przemykomo/nixie-watch/README.md

# Nixie Watch

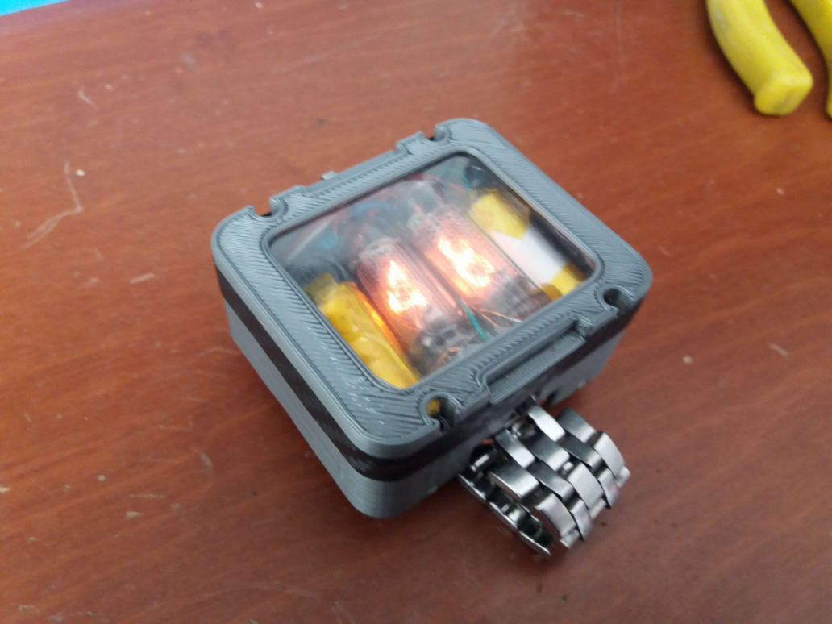
[picture p1: img/showcase.png]
Nixie Watch
