przemykomo/nixie-watch/models/watch_model.FCStd

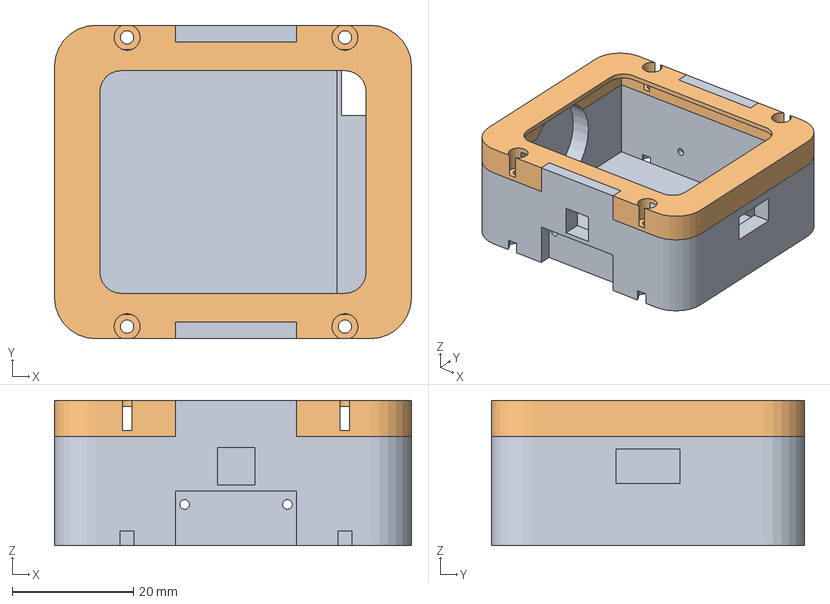
[picture p2: CAD file, 2023-12-17]
models/watch_model.FCStd
59.0 x 51.8 x 24.0 mm
Bottom (Meshed)
Top (Meshed)
