przemykomo/nixie-watch/schematics/nixiewatch.kicad_pcb

## KiCad design schematics/nixiewatch.kicad_pcb (2023-06-13)

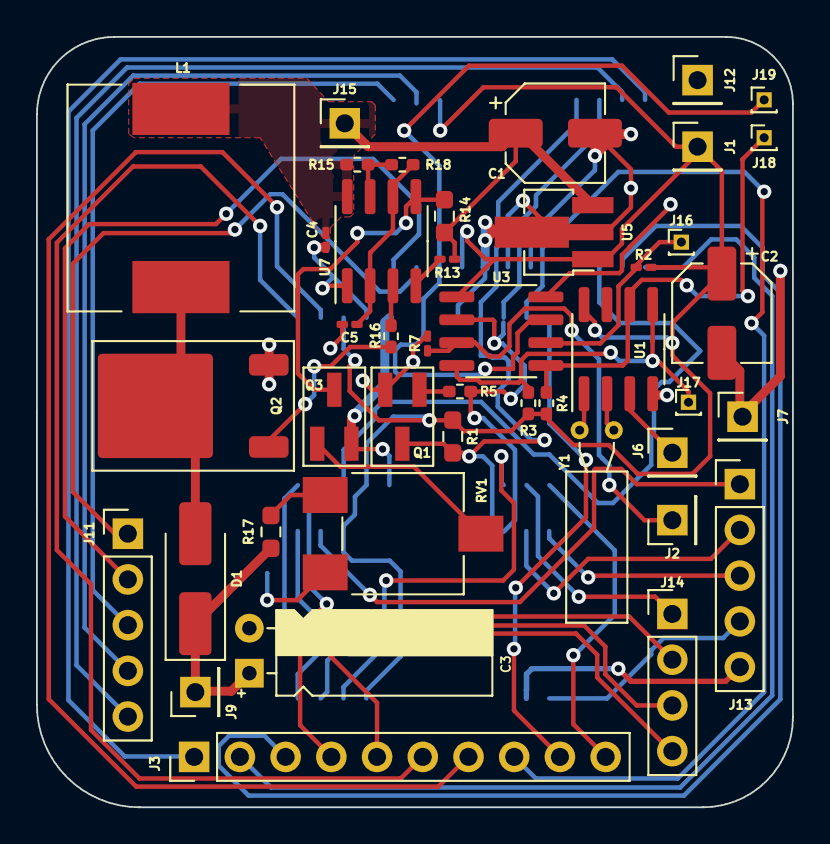
[picture p3: board nixiewatch.kicad_pcb from above]

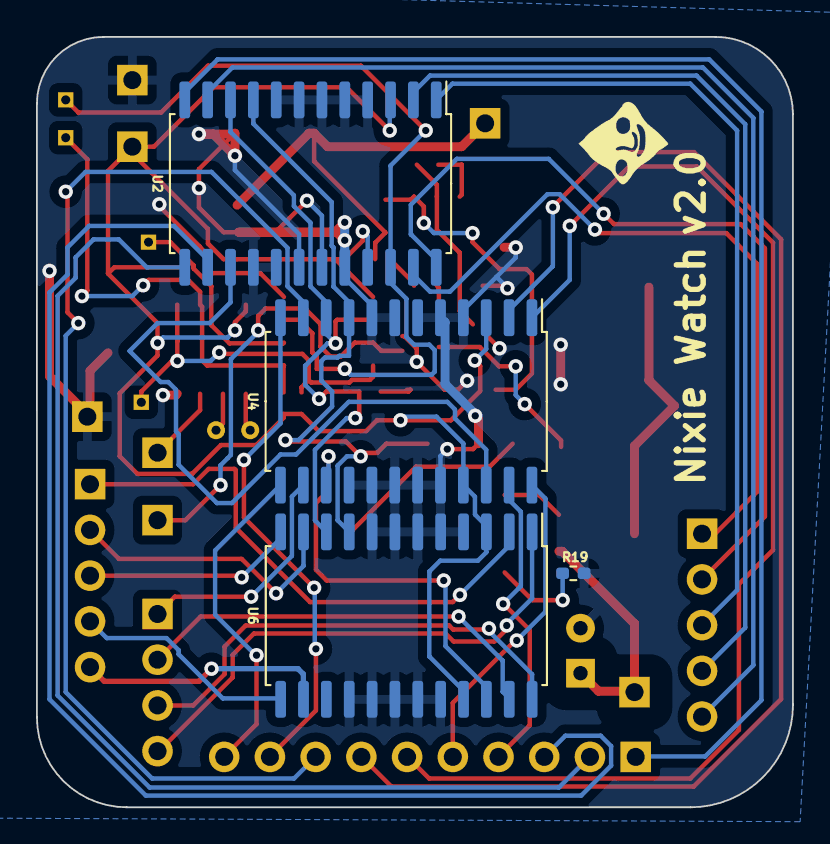
[picture p4: board nixiewatch.kicad_pcb from below]

Board: 2 copper layers, 42.0 x 42.8 mm, 47 parts (4 on the bottom side), 51 nets.

Parts:
C1, C2: 33u; CP_Elec_5x5.3
C3: 1u 200V; CP_RADIAL_D5.00mm_P2.50mm_H12.0mm_Horizontal
C4: 100n; C_0201_0603Metric_Pad0.64x0.40mm_HandSolder
C5: 2n2; C_0201_0603Metric_Pad0.64x0.40mm_HandSolder
D1: S1K; D_SMA_Handsoldering
J1, J9: ButtonH; PinHeader_1x01_P2.54mm_Vertical
J2: ButtonL; PinHeader_1x01_P2.54mm_Vertical
J3: Conn_01x10; PinHeader_1x10_P2.54mm_Vertical
J6: BT2_3V; PinHeader_1x01_P2.54mm_Vertical
J7: BT2GND; PinHeader_1x01_P2.54mm_Vertical
J11, J13: Conn_01x05; PinHeader_1x05_P2.54mm_Vertical
J12: BTGND; PinHeader_1x01_P2.54mm_Vertical
J14: Conn_01x04; PinHeader_1x04_P2.54mm_Vertical
J15: BT1_8V; PinHeader_1x01_P2.54mm_Vertical
J16: reset; PinHeader_1x01_P1.00mm_Vertical
J17: mosi; PinHeader_1x01_P1.00mm_Vertical
J18: miso; PinHeader_1x01_P1.00mm_Vertical
J19: sck; PinHeader_1x01_P1.00mm_Vertical
L1: 180u; L_12x12mm_H8mm
Q1, Q3: BC846A; SOT-23_Handsoldering
Q2: WMO10N60C2; TO-252-2
R1, R14: 51k; R_0603_1608Metric_Pad0.98x0.95mm_HandSolder
R2, R7, R13: 20k; R_0201_0603Metric_Pad0.64x0.40mm_HandSolder
R3, R4: 2k2; R_0402_1005Metric_Pad0.72x0.64mm_HandSolder
R5: 6k8; R_0402_1005Metric_Pad0.72x0.64mm_HandSolder
R15: 1k; R_0402_1005Metric_Pad0.72x0.64mm_HandSolder
R16: 100; R_0402_1005Metric_Pad0.72x0.64mm_HandSolder
R17: 680k; R_0603_1608Metric_Pad0.98x0.95mm_HandSolder
R18: 10k; R_0402_1005Metric_Pad0.72x0.64mm_HandSolder
R19: 470; R_0402_1005Metric_Pad0.72x0.64mm_HandSolder
RV1: 5k; Potentiometer_ACP_CA6-VSMD_Vertical
U1: DS1307Z+; SOIC-8_3.9x4.9mm_P1.27mm
U2, U4, U6: TPIC6A595DWR; SOIC-24W_7.5x15.4mm_P1.27mm
U3: ATtiny412-SS; SOIC-8_3.9x4.9mm_P1.27mm
U5: DI78M05UAB; SOT-89-3_Handsoldering
U7: NE555D; SOIC-8_3.9x4.9mm_P1.27mm
Y1: 32.768kHz 12.5pF; Crystal_C38-LF_D3.0mm_L8.0mm_Horizontal

Connections:
+3V0: J6.1, U1.3 (VBAT)
+5V: C2.1, J1.1, R1.2, R2.2, R3.1, R4.1, U1.8 (VCC), U2.3 (~SRCLR), U2.21 (VCC), U3.1 (VCC), U4.3 (~SRCLR), U4.21 (VCC), U5.1 (VO), U6.3 (~SRCLR), U6.21 (VCC)
+170V: C3.1, D1.1 (K), J9.1, R17.1
+BATT: C1.1, C4.1, J15.1, L1.1, R13.1, R14.1, R15.1, U5.3 (VI), U7.8 (VCC)
/170V_int: D1.2 (A), L1.2, Q2.2 (D)
/RCK: Q1.3 (C), R1.1, U2.9 (RCK), U4.9 (RCK), U6.9 (RCK)
/SERIAL_DATA: J19.1, U2.22 (SER_IN), U3.7 (PA3)
/SRCK: R5.2, U2.10 (SRCK), U3.2 (PA6), U4.10 (SRCK), U6.10 (SRCK)
GND: C1.2, C2.2, C3.2, C4.2, C5.2, J7.1, J12.1, Q1.2 (E), Q2.3 (S), Q3.2 (E), R7.1, R19.2, U1.4 (GND), U2.4 (~G), U2.5 (PGND), U2.6 (PGND), U2.7 (PGND), U2.8 (PGND), U2.16 (LGND), U2.17 (PGND), U2.18 (PGND), U2.19 (PGND), U2.20 (PGND), U3.8 (GND), U4.4 (~G), U4.5 (PGND), U4.6 (PGND), U4.7 (PGND), U4.8 (PGND), U4.16 (LGND), U4.17 (PGND), U4.18 (PGND), U4.19 (PGND), U4.20 (PGND), U5.2 (GND), U6.4 (~G), U6.5 (PGND), U6.6 (PGND), U6.7 (PGND), U6.8 (PGND), U6.16 (LGND), U6.17 (PGND), U6.18 (PGND), U6.19 (PGND), U6.20 (PGND), U7.1 (GND)
unnamed: J2.1, R7.2, U3.3 (PA7)
unnamed: J3.1, U2.12 (DRAIN5)
unnamed: J3.2, U2.13 (DRAIN6)
unnamed: J3.3, U2.14 (DRAIN7)
unnamed: J3.4, U4.23 (DRAIN0)
unnamed: J3.5, U4.24 (DRAIN1)
unnamed: J3.6, U4.1 (DRAIN2)
unnamed: J3.7, U4.2 (DRAIN3)
unnamed: J3.8, U4.11 (DRAIN4)
unnamed: J3.9, U4.12 (DRAIN5)
unnamed: J3.10, U4.13 (DRAIN6)
unnamed: J11.1, U2.23 (DRAIN0)
unnamed: J11.2, U2.24 (DRAIN1)
unnamed: J11.3, U2.1 (DRAIN2)
unnamed: J11.4, U2.2 (DRAIN3)
unnamed: J11.5, U2.11 (DRAIN4)
unnamed: J13.1, U6.2 (DRAIN3)
unnamed: J13.2, U6.11 (DRAIN4)
unnamed: J13.3, U6.12 (DRAIN5)
unnamed: J13.4, U6.13 (DRAIN6)
unnamed: J13.5, U6.14 (DRAIN7)
unnamed: J14.1, U4.14 (DRAIN7)
unnamed: J14.2, U6.23 (DRAIN0)
unnamed: J14.3, U6.24 (DRAIN1)
unnamed: J14.4, U6.1 (DRAIN2)
unnamed: J16.1, R2.1, U3.6 (~RESET/PA0)
unnamed: J17.1, R3.2, U1.5 (SDA), U3.4 (PA1)
unnamed: J18.1, R4.2, U1.6 (SCL), U3.5 (PA2)
unnamed: Q1.1 (B), R5.1
unnamed: Q2.1 (G), R16.1
unnamed: Q3.1 (B), RV1.2
unnamed: Q3.3 (C), R14.2, U7.5 (CV)
unnamed: R17.2, RV1.3
unnamed: R19.1, RV1.1
unnamed: U1.1 (X1), Y1.1
unnamed: U1.2 (X2), Y1.2
unnamed: U2.15 (SER_OUT), U4.22 (SER_IN)
unnamed: U4.15 (SER_OUT), U6.22 (SER_IN)
unnamed: R15.2, R18.1, U7.7 (DIS)
unnamed: R16.2, U7.3 (Q)
unnamed: R13.2, U7.4 (R)
unnamed: C5.1, R18.2, U7.2 (TR), U7.6 (THR)
