przemykomo/nixie-watch/(commit log)

2023-04-19 allow user to set time
    [nixiewatch.kicad_sch]
2023-04-19 pcb layout
    [nixiewatch.kicad_pcb, nixiewatch.kicad_sch]
2023-04-24 cleaned up the schematic
    [nixiewatch.kicad_pcb, nixiewatch.kicad_sch]
2023-05-18 smd version
    [nixiewatch.kicad_pcb, nixiewatch.kicad_sch]
2023-12-17 added model and showcase img
    [watch_model.FCStd]
